AnTaeHun/ict_MOVENS/README.md

자동제어 기능이 탑재된 교육용 애완 로봇 DIY 키트

A. 프로젝트 개요

1. 프로젝트 소개 

- 사족보행 로봇의 기구설계 및 아두이노를 통해 자세 제어 시스템을 구현하는 교육용  애완 로봇  DIY키트 
- 개별화된 서보모터 구성으로 Assembly Kit Block으로 제작됨. 블럭 조립 형태의 DIY 키트
- 완제품이 아닌 DIY키트로 제작하여 직접 제작하며 과학적 재능을 키우고 흥미를 쉽게 느낄 수 있도록 유도함

2. 개발배경 및 필요성

- 4차 산업혁명을 앞두고 국가 8대 기술 과제 중 하나로 로봇이 큰 관심을 받고 있다. 또한 이에 관련된 인재 양성이 중요시 되고 있다. 특히 최근 “보스턴 다이나믹스”에서 4족 보행 로봇인 로봇개 “스팟”을 개발 및 판매를 실시하여 큰 화제가 되었다. 국내의 대기업 중 하나인 SK 하이닉스가 반도체 공장에 안전 관리용 로봇으로 이 “스팟”을 투입하는 등 로봇에 대한 관심 및 인기가 높아지고 있다.

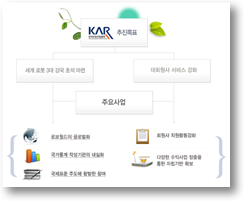
[picture p1: img/9-1.png]
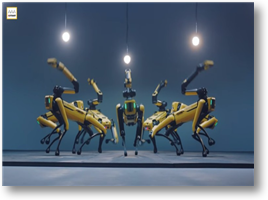
[picture p2: img/9-2.png]
  

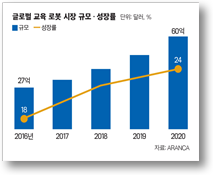
[picture p3: img/10-1.png]
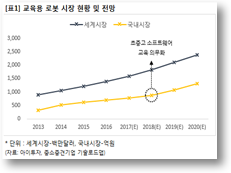
[picture p4: img/10-2.png]
-  로봇 분야는 기계화 및 자동제어 기술로써 미래산업에서는 빼놓을 수 없는 필수 분야이다. 이에 맞춰 학생들의 로봇 지식 조기교육의 필요성과 관심도가 높아지고 있다. 이를 응용 학습하기 위해 교육용 애완로봇 DIY 키트를 제작하고자 한다.

- 지난해 통계청의 조사에 따르면 우리나라 청소년은 하루 4시간씩 인터넷을 사용하고 10명 중 4명은 스마트폰 과의존 상태인 것으로 나타났다. 통계청에서 발표한 자료에 따르면 지난해 10대 청소년 인터넷·스마트폰 이용 시간은 일주일에 27.6시간으로 큰 비중을 차지하고 있었다. 또한 청소년 게임이용자들이 2021년 하루 평균 플레이한 시간은 주중 2.53시간, 주말 2.88시간으로 일반이용자의 주중 1.66시간, 주말 2.25시간보다 높게 나타났다.   <2021년 청소년 통계>-통계청
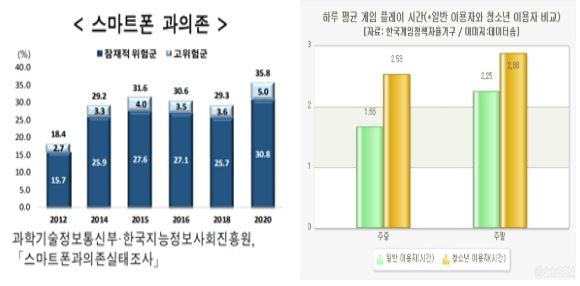
[picture p5: img/1.JPG]
- 
- 위의 자료에서 보이는 것처럼 청소년들이 대부분의 여가생활을 스마트폰과 PC게임에 소비하고 있으며 이 때문에 학업에 대한 흥미와 과학적 소질을 개발할 기회를 잃는 것이 우려되고 있다. 우리는 이 제품을 통해 과학(구동원리 및 전자제어 등)에 대한 흥미를 기르고 동기를 부여하여 청소년들의 능력 개발 및 진로 탐색의 기회를 제공하고자 한다.

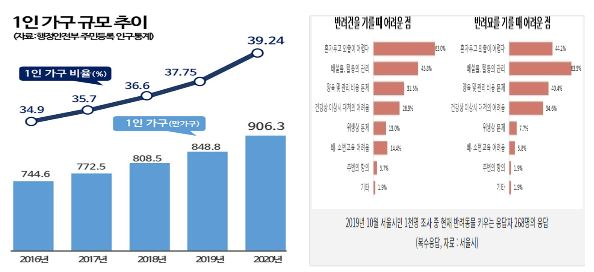
[picture p6: img/2.JPG]


- 또한 현재 반려동물을 키우고자 하는 가구의 수가 매년 증가하는 추세이다. 하지만 반려동물의 경우 관리하는 비용과 시간이 많이 소모되어 기르는 것을 주저하는 가구가 많다. 하지만 이 애완 로봇 DIY키트의 경우 관리하는 비용과 시간이 적게 들어 반려동물의 대체가 가능할 것으로 예상된다.

3. 국내/외 기술 현황

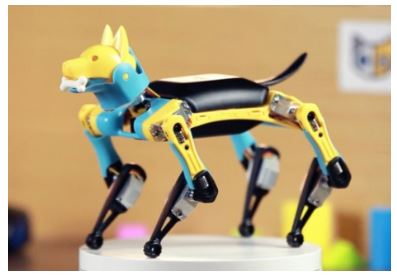
[picture p7: img/비틀.JPG]
비틀


- Petoi - 비틀(국외)
- 해외 제품으로 움직임이 부드럽고 자연스럽다. 중심도 잘 잡혀있고 뒤집히더라도 스스로 다시 일어날 수 있다. 사람이 밟고 지나가도 부서지지 않을만큼 튼튼하다. DIY 키트 방식으로 소비자가 조립하며 코딩도 직접 할 수 있어 우리 프로젝트와 가장 유사하지만 가격이 비싸고 조립 과정이 쉽지 않다는 단점이 있다.

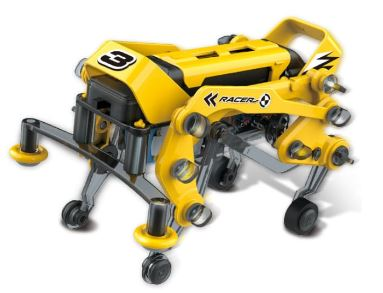
[picture p8: img/경주로봇.JPG]
경주로봇


- 아카데미과학 - 경주로봇(국내)
- 국내 제품으로 단순한 동작이 가능한 DIY키트이다. 크랭크 축, 건전지의 장착 방향, 다리각도 수정 등의 작업으로 달리기와 걷기 등을 바꿀 수 있다. 가격은 저렴하지만 단순한 동작만 가능하고 코딩 관련 내용은 없다는 단점이 있다.

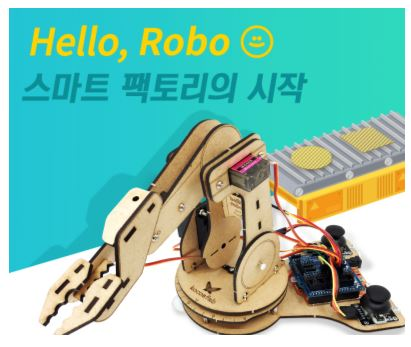
[picture p9: img/로봇팔키트.JPG]
로봇팔키트


- 코코아팹 - 로봇팔 키트(국내)
- 아두이노 코딩연습을 할 수 있는 DIY키트이다. 아두이노, 모터, 조이스틱 등 간단한 부품과 모듈을 사용해서 코딩 연습을 할 수 있는 교육용 키트이다. 가격은 저렴하지만 단순한 동작만 가능하고 애완로봇으로서 기능하지 못한다는 단점이 있다.

4. 개발 목표 및 내용 

- 최종 개발 목표
  1. 간단한 부품구성으로 누구나 조립할 수 있게 만들기
  2. 부드러운 움직임 구현
  3. 걷기 및 방향전환 등의 동작 중에 넘어지지 않게 하기
  4. 청소년들이 쉽게 흥미를 느낄 수 있는 외형으로 디자인하기

- 주요 개발내용(기능중심)
  1. 누구나 쉽게 조립할 수 있도록 부품의 간단화 및 설계도 제작
  2. 로봇개의 외형 모델링(자연스러운 움직임 / 흥미 유발)
  3. 아두이노 코딩 (걷기, 앉았다 일어나기, 방향전환 등 간단한 동작 구현)
  4. 블루투스 기능을 사용하여 스마트폰과 연동, 스마트폰을 통한 동작 제어
- 기존 기술 활용여부 및 차별성
  1. 비틀의 내부 구조를 참고하여 설계 시작
  2. 나사가 적게 들어가 조립이 더 쉽다
  3. 국내 키트들에 비해 더 다양한 동작이 가능
  4. 유사 제품(비틀) 대비 적은 비용으로 제작 가능

B. 프로젝트 내용

1. 구성도

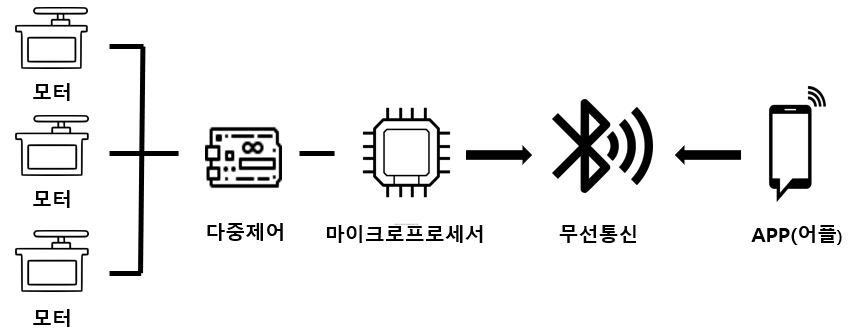
[picture p10: img/구성도2.png]
구성도2


2. 주요기능

   S/W

   - 동작제어 :  PCA9685 16채널 12비트 PWM 서보 드라이버를 사용해 12개의 모터를 독립적으로 움직여 보다 자연스러운 움직임을 구현함
   - 통신 : 블루투스 직렬포트 모듈 HC-06 (DIP)를 사용해 스마트폰과 연동하여 동작을 제어할 수 있음

   HW

   - 외형 : 완제품이 아닌 개별로 된 부품을 소바자가 직접 조립하며 완성해 나갈 수 있도록 설계. 누구나 좋아할 수 있는 외형. 움직임에 있어서 부품간 간섭이 생기지 않고 자연스럽게 움직일 수 있도록 설계

   - 모터 : 각 모터의 독립적인 운동을 구현해 끊기지 않는 자연스러운 움직임을 구현함

3. 적용기술

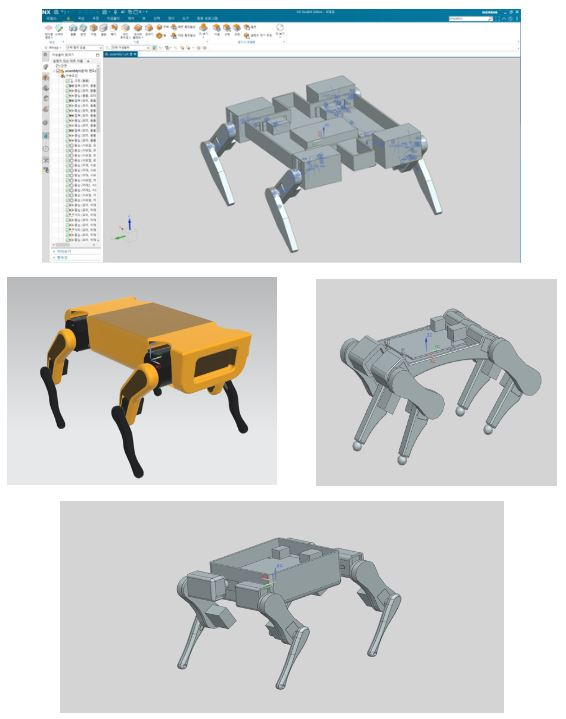
[picture p11: img/모델링.JPG]
모델링
   - S/W - 제품의 내부 골격 및 외형을 3D모델로 설계하기 위한 CAD 프로그램 (UG NX 사용) 
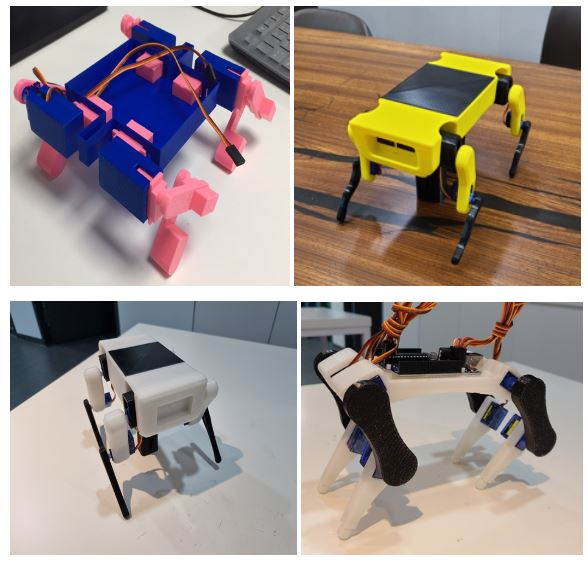
[picture p12: img/출력.JPG]
출력
   - 3D프린터 - DIY키트에 포함될 부품들을 정확한 모양 및 크기로 출력

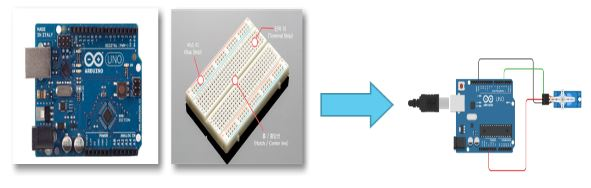
[picture p13: img/컴퓨팅.JPG]
컴퓨팅
   -  컴퓨팅 기술 – 소형 컴퓨터인 아두이노를 통한 모터의 동작 제어
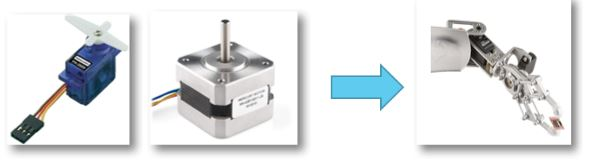
[picture p14: img/모터.JPG]
모터
   - 모터 – 제품의 관절에 소형 모터를 배치하여 자연스러운 움직임을 표현
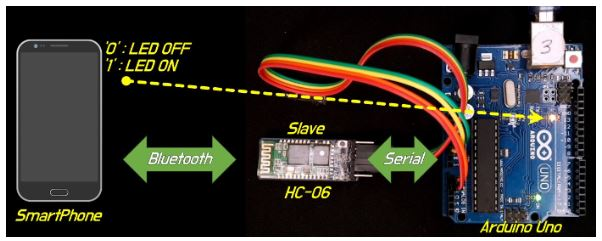
[picture p15: img/블루투스.JPG]
블루투스
   - 블루투스 – 스마트폰과 연동하여 제어 가능

4. 예상 결과물

- 구성도2
  -  아두이노를 통해 모터의 동작제어
  - 블루투스 모듈을 통해 스마트폰과 연동하여 동작제어 가능
  - 간단한 동작(걷기, 방향전환, 앉았다 일어나기 등)을 구현
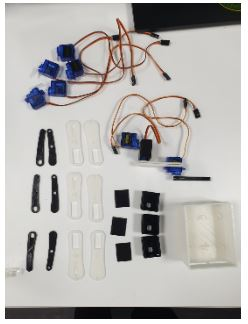
[picture p16: img/분해도.JPG]
분해도
- 
  - 완제품이 아닌 DIY키트로 구성되어 청소년들의 교육용으로 사용이 가능하다.
  - 저연령층이 선호할 외형을 채용하여 쉽게 접근할 수 있게 하고 흥미를 유도하도록 한다.

C. 프로젝트 수행내용

1. 프로젝트 수행일정

   | 프로젝트 기간 (한이음 사이트 기준) | 2022.04.12. ~ 2022.11.30. |
   | :--------------------------------: | :-----------------------: |

   |  구분  |           추진 내용           | 3월  | 4월  | 5월  | 6월  | 7월  | 8월  | 9월  | 10월 | 11월 |
   | :----: | :---------------------------: | :--: | :--: | :--: | :--: | :--: | :--: | :--: | :--: | :--: |
   |  계획  |  아이디어 회의 및 주제 선정   |  O   |  O   |      |      |      |      |      |      |      |
   |  분석  |     시장조사 및 특허 검색     |  O   |  O   |      |      |      |      |      |      |      |
   |  설계  |    2D스케치 및 2D도면 작업    |      |  O   |  O   |      |      |      |      |      |      |
   |  설계  |           3D모델링            |      |      |  O   |  O   |      |      |      |      |      |
   |  개발  |  센서에 필요한 아두이노 코딩  |      |      |      |      |  O   |  O   |  O   |      |      |
   |  개발  |          렌더링 작업          |      |      |      |      |      |      |  O   |  O   |      |
   |  개발  | 세푸 치수 선정 및 디테일 보완 |      |      |      |      |      |      |      |  O   |      |
   | 테스트 |                               |      |      |      |      |      |      |      |      |  O   |
   |  종류  |                               |      |      |      |      |      |      |      |      |  O   |

2. 프로젝트 수행 과정에서의 문제점 및 개선 사항

   - ver.1 > ver.2 (NX를 활용한 3D 모델링)

     - 모터의 노출된 부분이 커서 외관상 보기에 좋지 못함.
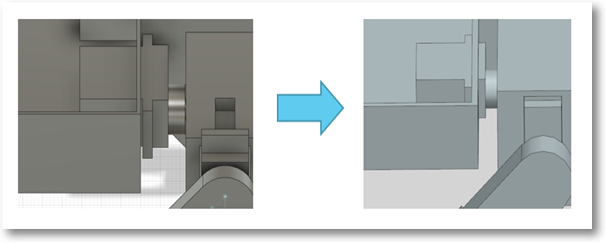
[picture p17: img/1-1.png]
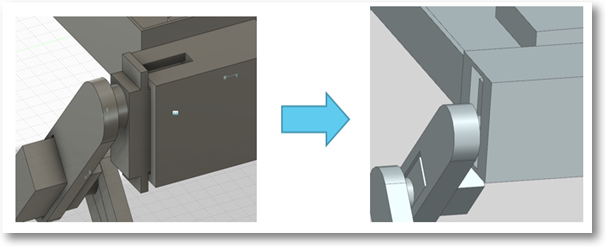
[picture p18: img/1-2.png]
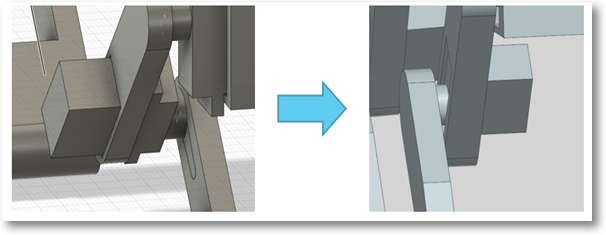
[picture p19: img/1-3.png]
     - 모터가 최대한 보이지 않게 부품별로 크기를 키움.

     - 기존의 모델은 모터의 선 정리가 미흡함.

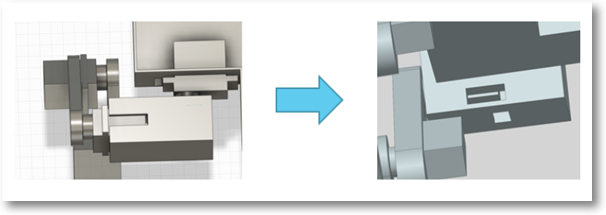
[picture p20: img/2-1.png]
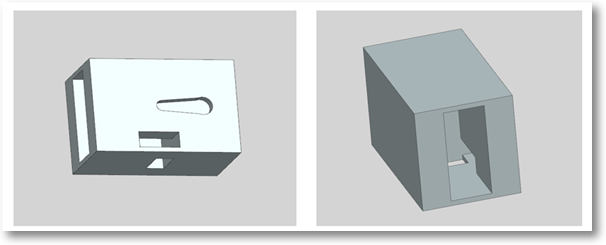
[picture p21: img/2-2.png]
     - 모터의 선을 넣을 수 있는 구멍을 어깨 부분에 추가하여 선이 바깥에서 최대한 보이지 않도록 설계 변경.

     - 3D프린터의 재료 특성상 발 부분이 매끄러워 평평한 면에서 미끄러짐.

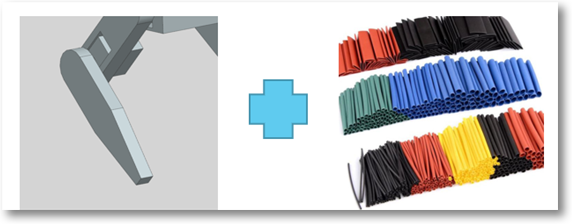
[picture p22: img/3-1.png]
     - 수축 튜브를 이용, 고무로 코팅한 것과 같은 효과를 얻음.

   - 2-2) ver.2 > ver.3 (NX를 활용한 3D 모델링 및 3D프린팅)

     - 외형이 미관상 좋지 못함.
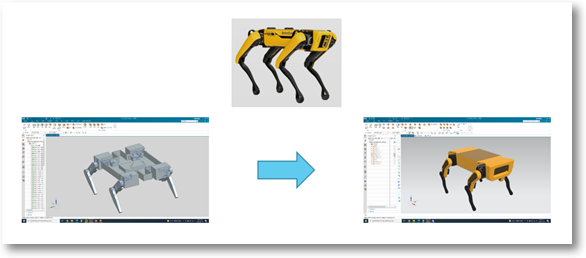
[picture p23: img/4-1.png]
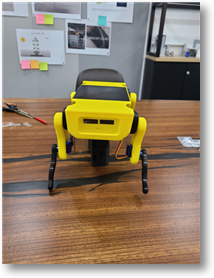
[picture p24: img/4-3.png]
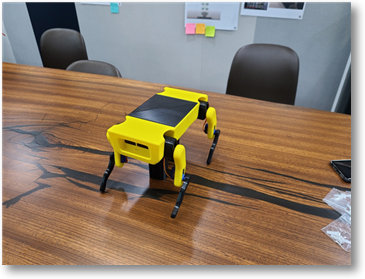
[picture p25: img/4-4.png]
     - 최근 각광받고 있는 로봇개 스팟의 외형을 참고하여 모델링 및 제작.

   -  ver.3 > ver.4 (NX를 활용한 3D모델링 및 3D프린팅)

     - 너무 무거워서 서보모터가 버티지 못함. (토크 부족)
     - 서보모터를 바꾸는 것보다 모델링을 수정하기로 결정. 크기를 대폭 축소.
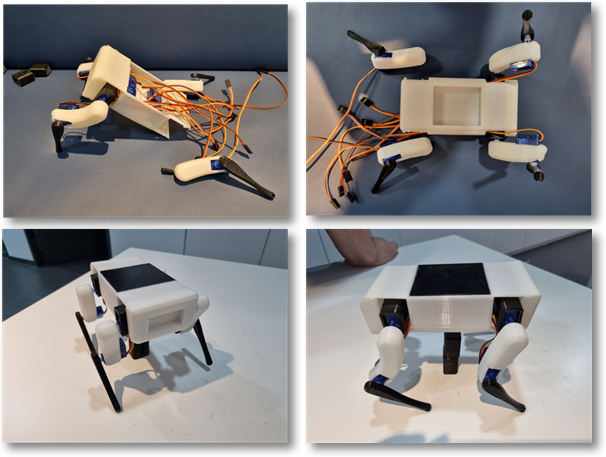
[picture p26: img/5-1.png]
     - 다리 외형도 수정.

   - ver.4 > ver.4.5 (NX를 활용한 3D모델링 및 3D프린팅)

     - 서보모터와 서보암 / 서보암과 각 부품들의 연결이 약함.
     - 모터와 서보암을 나사로 체결.
     - 각 부품을 반으로 나누어 서보암이 부품 내부로 들어와 조립할 수 있도록 설계.
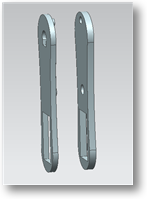
[picture p27: img/6-1.png]
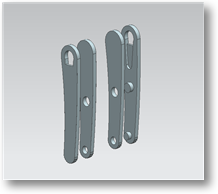
[picture p28: img/6-3.png]
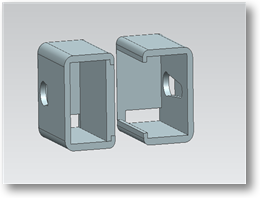
[picture p29: img/6-2.png]
     - 
     - 회의 결과 모델링보다 코딩 작업이 더 우선시 되어야 한다고 판단됨.
     - 5월에 신청한 실습 장비가 도착하여 코딩 작업이 가능해짐.
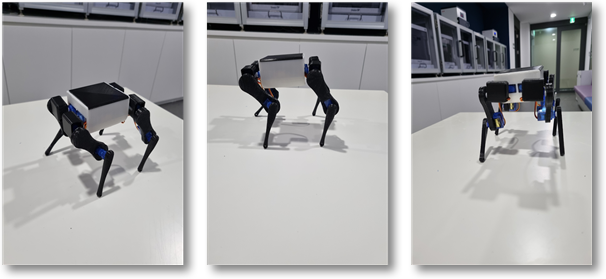
[picture p30: img/7-1.png]
     - 외형 디자인은 코딩 작업이 끝나고 나서 추가로 진행하기로 하고 우선은 코딩 연습을 하기 위해 간단한 디자인으로 재구성.

   - ver.4.5를 활용한 코딩 작업 시작

     - 다리 한쪽당 아두이노 한 개로 제어하려고 하니 각도를 맞추기 어려움.
     - 이후 서보 드라이버가 도착하면 해결될 것으로 예상됨.
     - 움직임이 뚝뚝 끊기면서 부자연스러움.
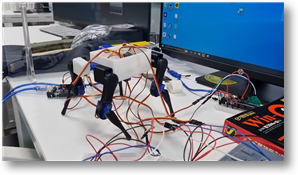
[picture p31: img/8-1.png]
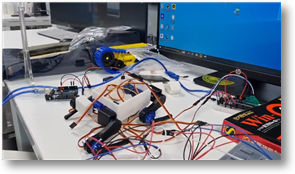
[picture p32: img/8-2.png]
     - 코드 재검토가 필요함. 지연시간을 늘려주고 다른 방식으로 코드를 수정해 볼 예정. 

4. Git 활용내용
   - Git 활용 현황
     - 문서화 이력 관리
     - P/G 아두이노 firmware
   - 향후  Git 활용 방안
     - 모델링 이력 관리
     - APP 응용 프로그램 이력 관리
5. 기대효과 및 개선사항
   - 기대효과
     - 청소년들의 로봇 분야에 대한 관심을 높일 수 있다.
     - 대중적으로 선호하는 외형 디자인을 적용하여 대중들의 흥미 유발 
     - 라즈베리파이를 이용하여 인공지능 스피커 기능 등 탑재 가능 
     - 확장 가능한 DIY 키트로 발전 가능(ex. 모듈 추가, 외형디자인 변화)
   - 개선사항
     -  누구나 쉽게 조립할 수 있도록 설계
     - 나사를 최대한 적게 사용
     - 청소년들이 흥미를 느낄만한 외형 디자인으로 구성
