AnTaeHun/ict_MOVENS/img/구성도.JPG

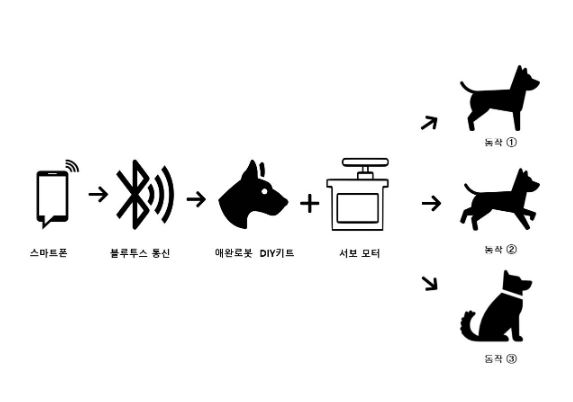
img/구성도.JPG
