AnTaeHun/ict_MOVENS/(commit log)

2022-07-08 수정완료
2022-07-08 브랜치수정
2022-07-08 수정했습니다
2022-07-08 프로잭트 개요
2022-07-08 프로잭트 개요 완료
2022-07-08 프로잭트 내용
2022-07-11 프로젝트 수행내용
2022-07-11 최종 수정
2022-07-11 이미지파일
2022-07-11 github로 팀작업 후 팀장이 취합하여 gitlab에 등록중
2022-07-11 사진 수정중
2022-07-11 서보모터 관련 연습용 코드 공유
